Tinkerforge/industrial-counter-bricklet/hardware/industrial-counter.FCStd

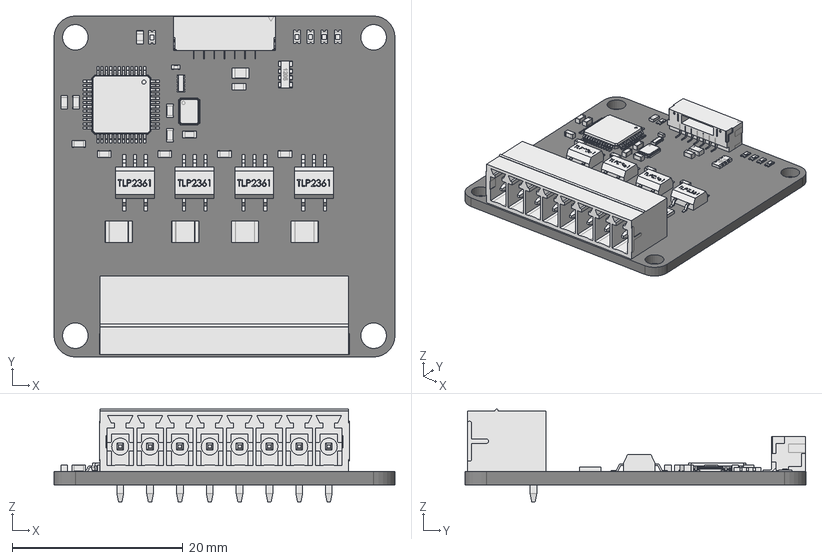
[picture p2: CAD file, 2018-04-16]
hardware/industrial-counter.FCStd
40.0 x 40.0 x 10.9 mm
Pcb
C_0603_
BrickletConn_7pin_
C_0402_
C_0603_001
C_0603_002
C_0603_003
C_0603_004
C_0603_005
C_0603_006
C_0603_007
C_0603_008
C_0603_009
C_0603_010
D_0603_blue_
D_0603_blue_001
D_0603_blue_002
D_0603_blue_003
D_0603_blue_004
8er_Phoenix_Buchse_
R_1210_
R_1210_001
R_1210_002
R_1210_003
R_4x0603_
lqfp48_7x7_p05_
R_0603_
C_0805_
SO-5_
SO-5_001
SO-5_002
SO-5_003
