Tinkerforge/industrial-counter-bricklet/hardware/industrial-counter-schematic.pdf

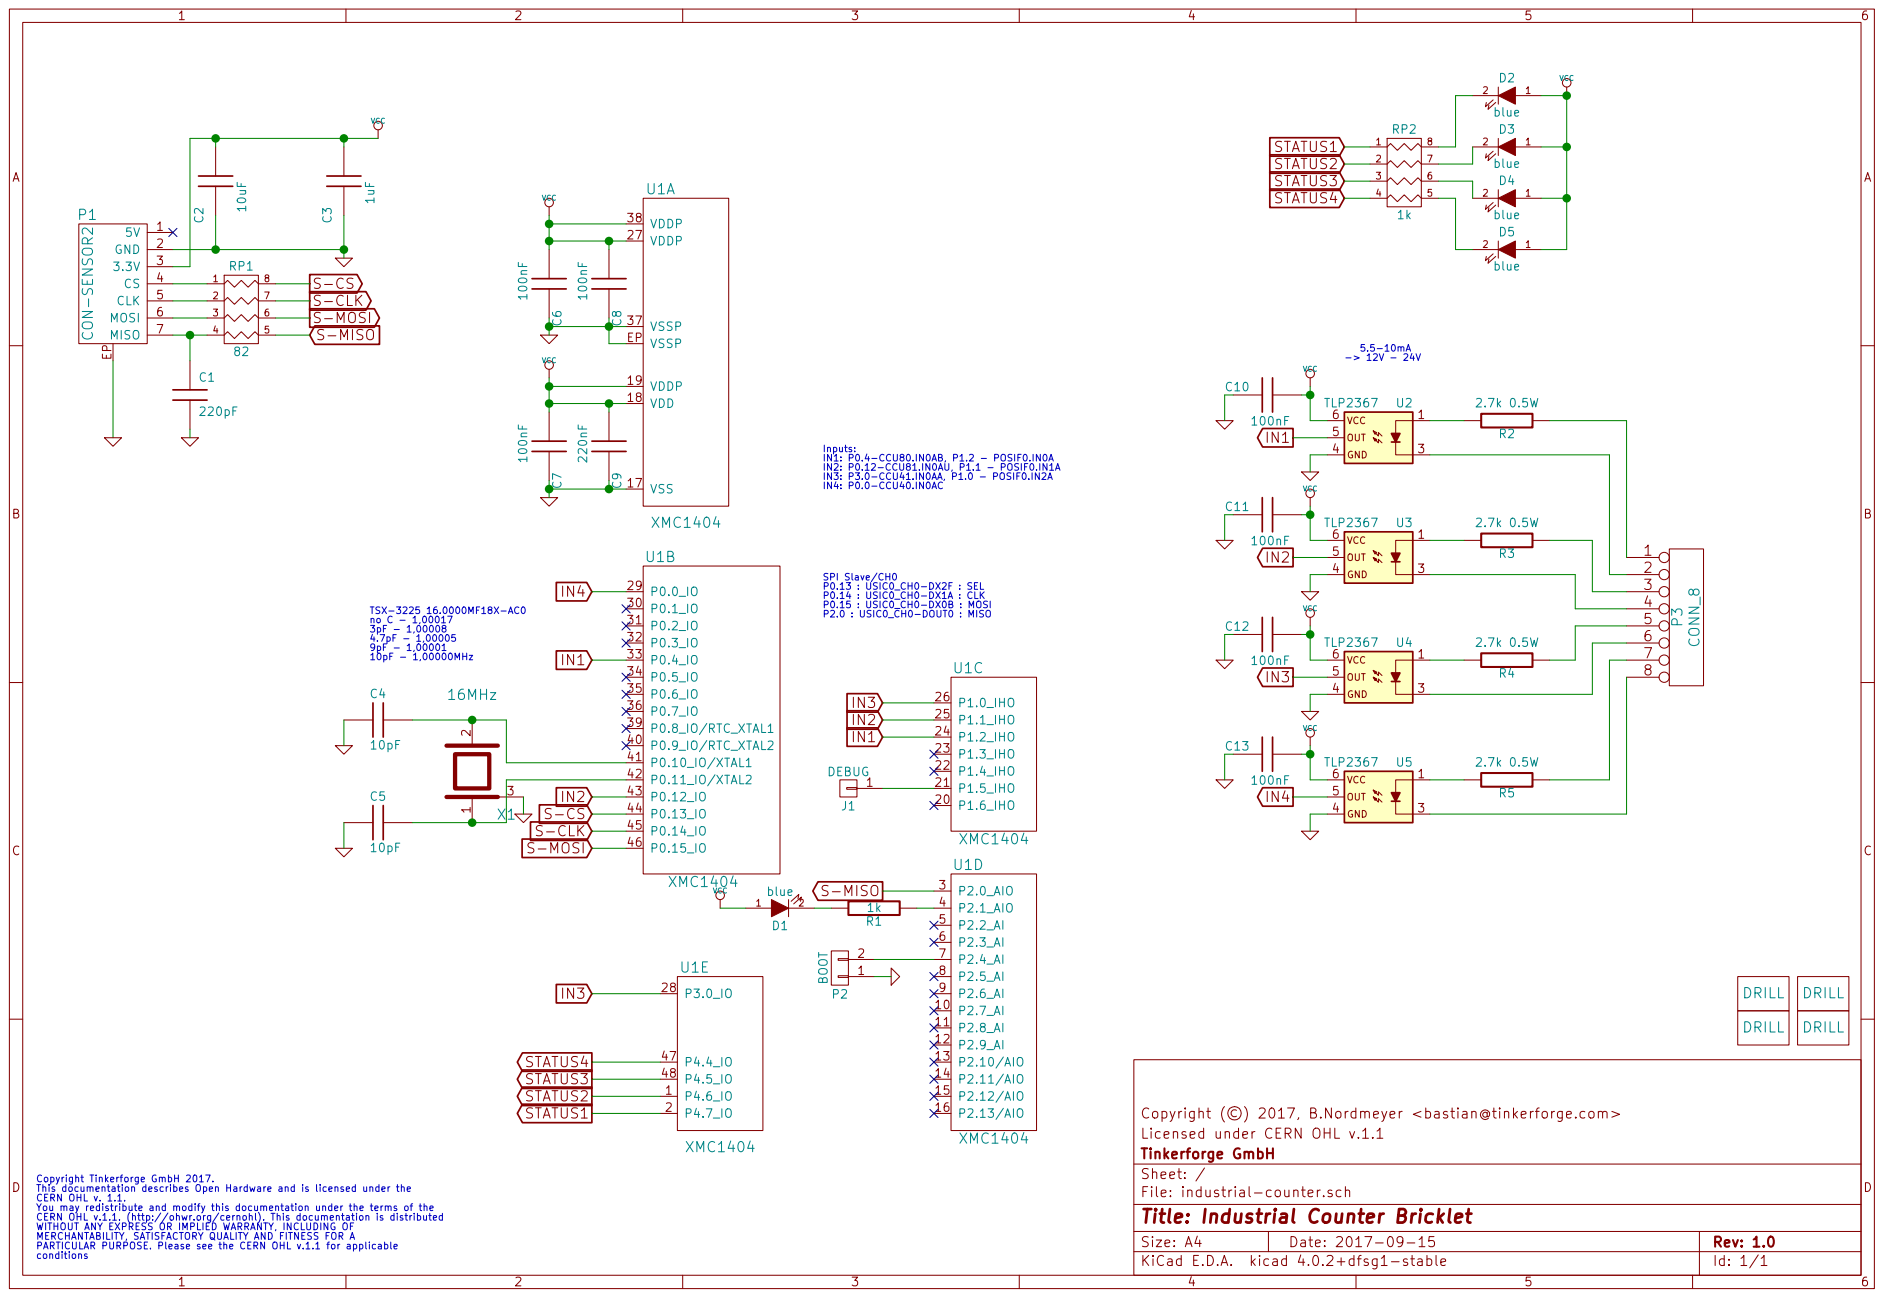
[picture p3: page 1]

VCC SPI Slave/CH0 P0.13 : USIC0_CH0-DX2F : SEL P0.14 : USIC0_CH0-DX1A : CLK

Licensed under CERN OHL v.1.1 Copyright (©) 2017, B.Nordmeyer <bastian@tinkerforge.com>

Id: 1/1 Title: Industrial Counter Bricklet File: industrial-counter.sch Sheet: / Tinkerforge GmbH

Copyright Tinkerforge GmbH 2017. This documentation describes Open Hardware and is licensed under the CERN OHL v. 1.1. You may redistribute and modify this documentation under the terms of the CERN OHL v.1.1. (http://ohwr.org/cernohl). This documentation is distributed WITHOUT ANY EXPRESS OR IMPLIED WARRANTY, INCLUDING OF MERCHANTABILITY, SATISFACTORY QUALITY AND FITNESS FOR A

PARTICULAR PURPOSE. Please see the CERN OHL v.1.1 for applicable
