Tinkerforge/industrial-counter-bricklet/hardware/industrial-counter.kicad_pcb

## KiCad design hardware/industrial-counter.kicad_pcb (2018-06-18)

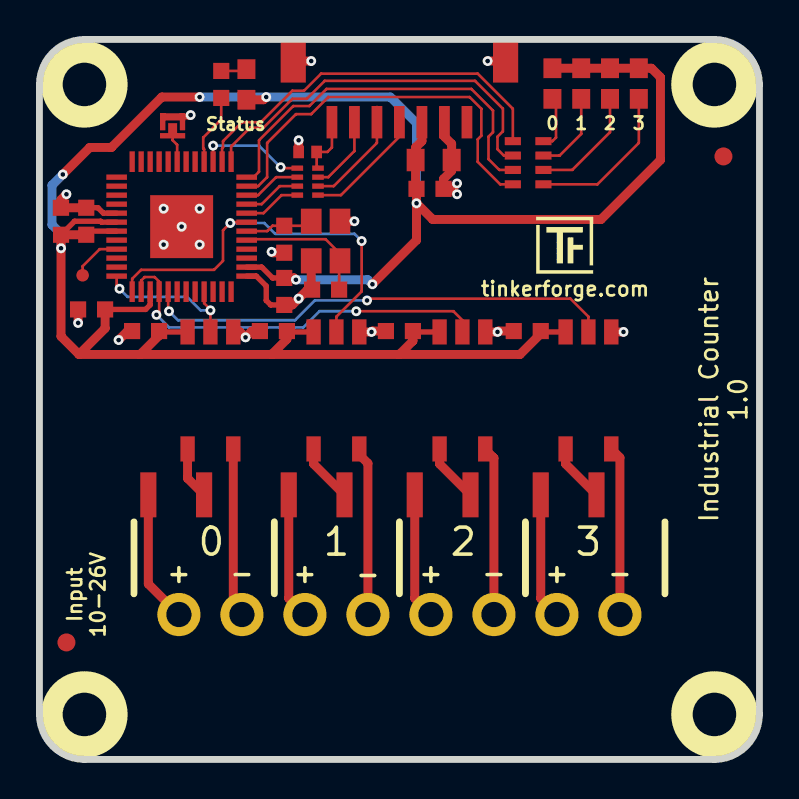
[picture p4: board industrial-counter.kicad_pcb from above]

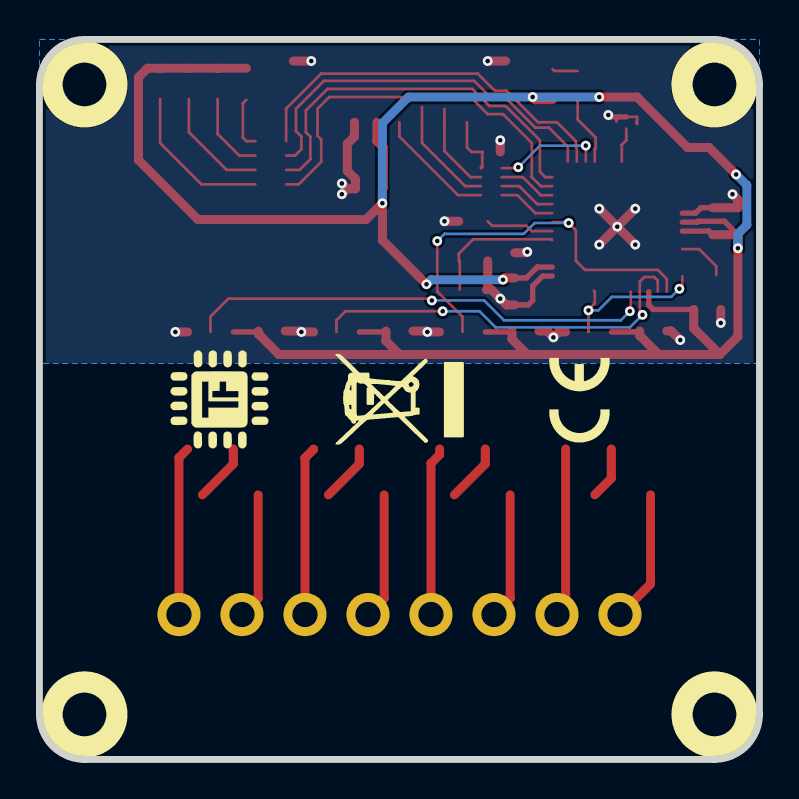
[picture p5: board industrial-counter.kicad_pcb from below]

Board: 2 copper layers, 40.0 x 40.0 mm, 43 parts (2 on the bottom side), 40 nets.

Parts:
C1: 220pF; C0402F
C2: 10uF; C0805
C3: 1uF; C0603F
C4, C5: 10pF; C0603F
C6, C7, C8, C10, C11, C12, C13: 100nF; C0603F
C9: 220nF; C0603F
D1, D2, D3, D4, D5: blue; D0603E
Fiducial_Mark: VAL**; Fiducial_Mark
Fiducial_Mark#2: VAL**; Fiducial_Mark
J1: DEBUG; DEBUG_PAD
P1: CON-SENSOR2
P2: BOOT; SolderJumper
P3: CONN_8; OQ_8P
R1: 1k; R0603F
R2, R3, R4, R5: 2.7k 0.5W; R1210
RP1: 82; 4X0402
RP2: 1k; 0603X4
U1: XMC1404; QFN48-EP2
U2, U3, U4, U5: TLP2367; SO-5
U6, U7, U8, U9: DRILL; DRILL_NP
VAL: CE_5mm
VAL#2: WEEE_7mm
X1: 16MHz; CRYSTAL_3225

Connections:
GND: C1.2, C2.1, C3.1, C4.2, C5.2, C6.2, C7.2, C8.2, C9.2, C10.2, C11.2, C12.2, C13.2, P1.2, P1.EP, P2.1, U1.17, U1.37, U1.EP, U2.4, U3.4, U4.4, U5.4, X1.3
IN1: U1.24, U1.33, U2.5
IN2: U1.25, U1.43, U3.5
IN3: U1.26, U1.28, U4.5
IN4: U1.29, U5.5
unnamed: C1.1, P1.7, RP1.4
unnamed: C4.1, U1.41, X1.2
unnamed: C5.1, U1.42, X1.1
unnamed: D1.2, R1.2
unnamed: D2.2, RP2.8
unnamed: D3.2, RP2.7
unnamed: D4.2, RP2.6
unnamed: D5.2, RP2.5
unnamed: J1.1, U1.21
unnamed: P1.4, RP1.1
unnamed: P1.5, RP1.2
unnamed: P1.6, RP1.3
unnamed: P2.2, U1.7
unnamed: P3.1, R2.1
unnamed: P3.2, U2.3
unnamed: P3.3, R3.1
unnamed: P3.4, U3.3
unnamed: P3.5, R4.1
unnamed: P3.6, U4.3
unnamed: P3.7, R5.1
unnamed: P3.8, U5.3
unnamed: R1.1, U1.4
unnamed: R2.2, U2.1
unnamed: R3.2, U3.1
unnamed: R4.2, U4.1
unnamed: R5.2, U5.1
S-CLK: RP1.7, U1.45
S-CS: RP1.8, U1.44
S-MISO: RP1.5, U1.3
S-MOSI: RP1.6, U1.46
STATUS1: RP2.1, U1.2
STATUS2: RP2.2, U1.1
STATUS3: RP2.3, U1.48
STATUS4: RP2.4, U1.47
VCC: C2.2, C3.2, C6.1, C7.1, C8.1, C9.1, C10.1, C11.1, C12.1, C13.1, D1.1, D2.1, D3.1, D4.1, D5.1, P1.3, U1.18, U1.19, U1.27, U1.38, U2.6, U3.6, U4.6, U5.6
