Tinkerforge/industrial-counter-bricklet/(commit log)

2017-09-18 finished prototype
    [industrial-counter-bricklet.kicad_pcb, industrial-counter-bricklet.sch]
2017-09-18 inputs documented
    [industrial-counter-bricklet.sch]
2017-09-27 change opto type
    [industrial-counter-bricklet.kicad_pcb, industrial-counter-bricklet.sch]
2017-10-13 Add initial software version
    Current state:
    * Working: counter, duty cycle, period, direction, pin value for CCU41
    * TODO: Frequency and implementation for CCU40, CCU80 and CCU81 + testing
    [cmake_config_custom.txt]
2017-10-13 Fix copy and paste error
    [counter.c]
2018-02-20 Cleanup KiCad libraries config
    Ensure LibDir=kicad-libraries and LibName1=tinkerforge.
    Remove special library.
2018-03-07 fix tlp2367 footprints
    [industrial-counter-bricklet.kicad_pcb, industrial-counter-bricklet.sch]
2018-03-08 Add missing interrupts and slice configuration
    [communication.c, communication.h, counter.c]
2018-03-09 Fix off-by one in frequency integration time calculation
    [counter.c]
2018-03-09 Make sure that timer are cleared during reconfiguration
2018-03-09 Remove debug led toggles
2018-03-09 Add proper LED handling for signal on/off
2018-03-09 Handle falling/rising correctly (optocoupler inverts signal)
    [counter.c]
2018-03-09 specify resistor values and input range
    [industrial-counter-bricklet.kicad_pcb, industrial-counter-bricklet.sch]
2018-03-15 fix logos
    [industrial-counter-bricklet.kicad_pcb]
2018-03-16 fix mounting hole
    [industrial-counter-bricklet.kicad_pcb]
2018-03-16 change product name placement
    [industrial-counter-bricklet.kicad_pcb]
2018-03-16 fix led text size
    [industrial-counter-bricklet.kicad_pcb]
2018-03-27 specify processor
    [industrial-counter-bricklet.kicad_pcb, industrial-counter-bricklet.sch]
2018-04-11 Add info LED config support
2018-04-16 Add 3d information (final)
    [industrial-counter-bricklet.kicad_pcb]
2018-04-16 Add 3d model (*.FCStd & *.step)
    [industrial-counter-bricklet.FCStd]
2018-05-02 Rename info LED to channel LED and fix typo
    [communication.c, communication.h, counter.c, counter.h]
2018-05-04 Rename files
    [industrial-counter.FCStd, industrial-counter.kicad_pcb, industrial-counter.sch]
2018-05-04 Add schematic PDF
2018-05-29 Adapt firmware to Bindings API changes
    [communication.c, communication.h, counter.c, counter.h]
2018-06-05 Fix channel check (off-by-one)
    [communication.c]
2018-06-18 Change capacitor footprint(s) to C0402F
    [industrial-counter.kicad_pcb, industrial-counter.sch]
2018-09-10 Add examples
    LabVIEW examples still missing.
    [example_simple.c]
2019-02-04 Simplify LED setting logic
2019-05-29 Disallow SPITFP interrupt to disable IRQs
    The newest version of bricklib2 disables IRQs during SPITFP
    transfers by default. This needs to be turned off for this
    Bricklet since it has higher priority IRQs that can not wait.
    For this we set the SPITFP_NOT_ALLOWED_TO_DISABLE_IRQ define.
2020-01-03 Fix erroneous value_has_to_chnage-logic for callbacks
    [communication.c]
2020-02-05 Fix 0 to -1 transation handling and configure corresponding overflow correctly
    [counter.c]
2020-08-27 uc: Use %lld and %llu to print 64 bit integers.
2020-08-31 uc: Use fixed-with placeholders in format strings.
    [example_callback.c, example_simple.c]
2020-09-02 uc: Add example driver note.
2020-09-30 Fix bug in set_counter and counter range
    [counter.c, counter.h]
2020-10-16 uc: Fix divisor type.
    [example_simple.c]
2021-10-25 Update KiCad link
    https://www.kicad.org/blog/2021/10/Avoid-links-to-former-kicad-domain/
2022-04-27 uc: Adapt to bindings changes
    [example_callback.c, example_simple.c]
